Junglyfly/SYSU-EEG-BCI/00 - hardward_doc/stm32f407 ads1299.png

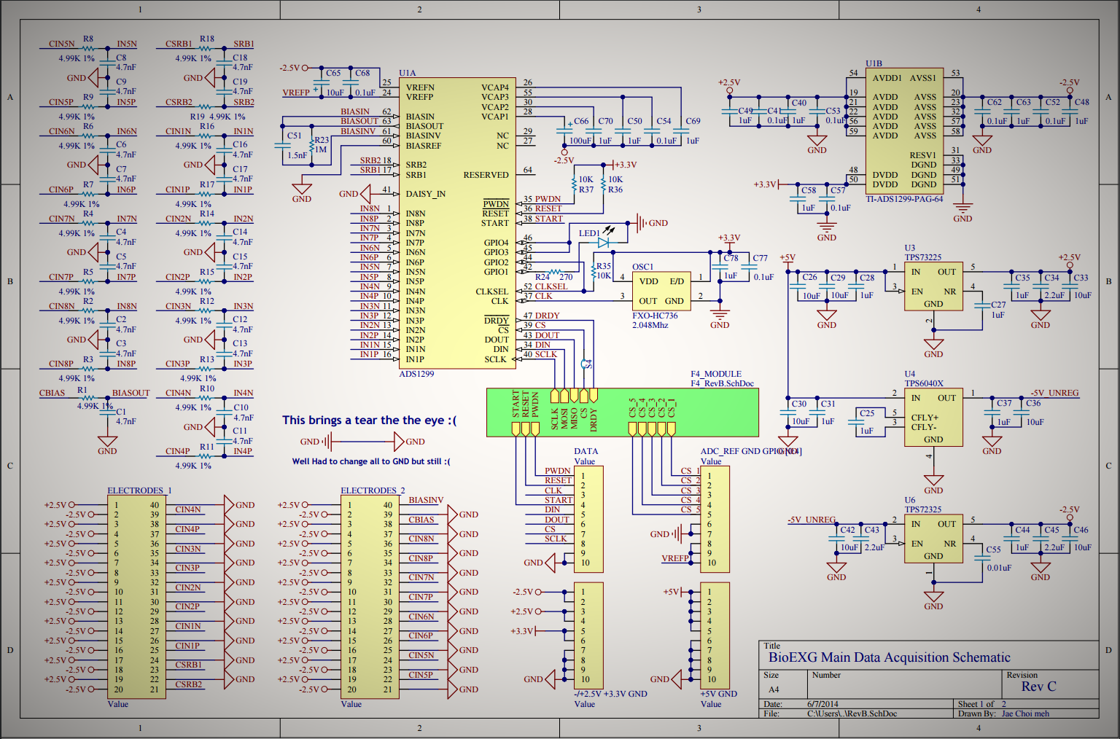
00 - hardward_doc/stm32f407 ads1299.png
