Junglyfly/SYSU-EEG-BCI/00 - hardward_doc/BIAS 连接多设备方法.PNG

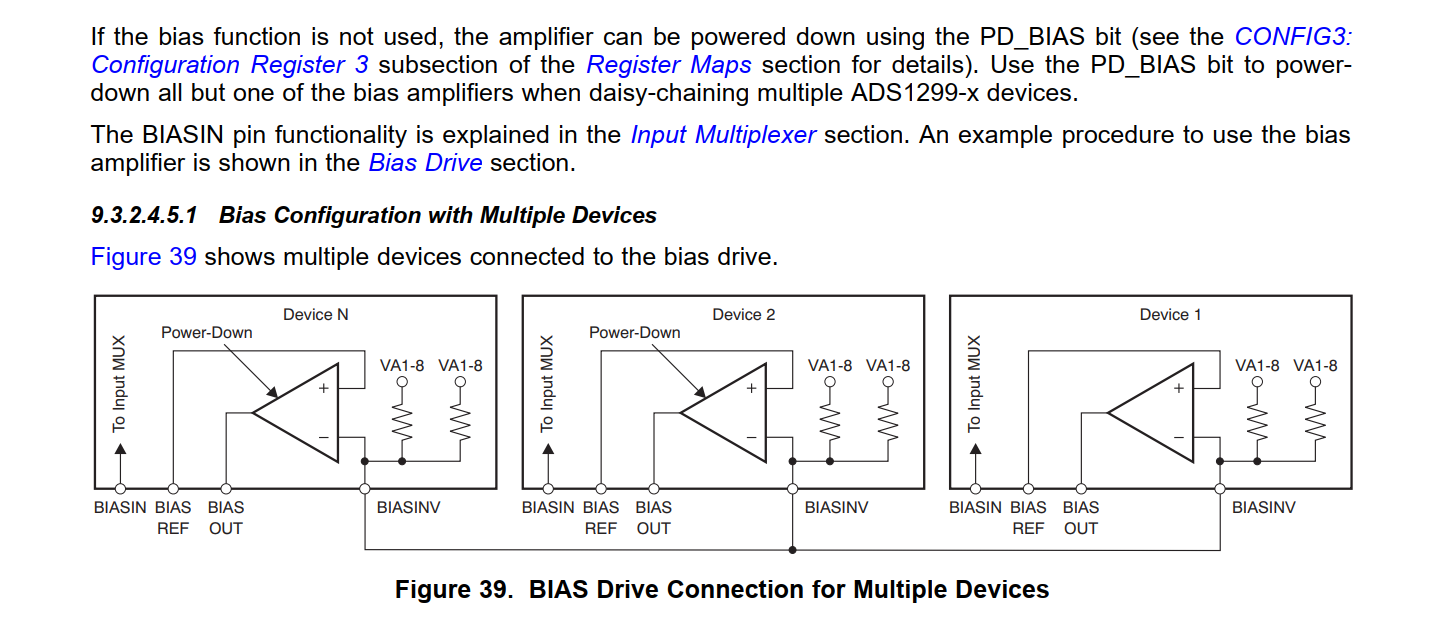
00 - hardward_doc/BIAS 连接多设备方法.PNG
