Junglyfly/SYSU-EEG-BCI/00 - hardward_doc/V3_Hardware_Design_Files-master/OpenBCI Cyton Designs/OBCI_Cyton_Plots/OBCI_Cyton_BOM.xlsx

 | OBCI_V3_C
Item | Board Ref | Qty | Component | Value | Package | Manufacturer | Part Number | Description | Notes
1 | C2,C4 | 2 | C | 100uF | SM 1206 | Yageo | CC1206MKX5R5BB107 | MLCC
2 | C1,C8,C25,C29,C31,C33,C37 | 7 | C | 10uF | SM0603 | Murata | GRM188C80G106KE47D | MLCC
3 | C32,C35,C36,C38,C40 | 5 | C | 2.2uF | EIA_0402 | Murata | GRM155C80J225ME95D | MLCC
4 | C39 | 1 | C | 2.2uF | EIA_0402 | Murata | GRM155R61C225KE44D | MLCC
5 | C6,C7,C14,C17,C18,C19,C21,C22,C27 | 9 | C | 1uF | EIA_0402 | Yageo | CC0402KRX7R5BB105 | MLCC
6 | C5,C10,C12,C13,C15,C24,C28 | 7 | C | 0.1uF | EIA_0402 | Yageo | CC0402KRX7R7BB104 | MLCC
7 | C30 | 1 | C | 0.01uF | EIA_0402 | Yageo | CC0402KRX7R7BB103 | MLCC
8 | C16 | 1 | C | 0.001uF | EIA_0402 | Yageo | CC0402KRX7R7BB102 | MLCC
9 | C20,C23 | 2 | C | 18pF | EIA_0402 | Yageo | CC0402JRNPO9BN180 | MLCC
10 | R1,R2,R3,R4,R6 | 5 | R | 2.2K | SM | BOURNS | CAY16-2201F4LF | 4 R-ARRAY
11 | C3,C9,C11,C26,C34 | 5 | C | 0.001uF | SM | TDK | CKCL44X7R1H102M085AA | 4 CAP ARRAY
12 | U1 | 1 | U |  | LGA | ST | LIS3DHTR | ST ACCELEROMETER
13 | U2 | 1 | U |  | SM | TI | SN74LVC1G32DCKR | OR_GATE
14 | U3 | 1 | U |  | SOT-23-6 | TI | LM2664M6/NOPB | V INVERTER
15 | U4 | 1 | U |  | SOT-23-5 | TI | TLV70025QDDCRQ1 | +2.5V LDO REG
16 | U5 | 1 | U |  | SM | Microchip | MCP1754T-3302E/OT | 3V3 LDO REG
17 | U6 | 1 | U |  | TQFP-64 | TI | ADS1299IPAG | ADS1299 | Consigned by OpenBCI, Inc
18 | U7 | 1 | U |  | SSOP-28 | Microchip | PIC32MX250F128B-I/SS | PIC32 MICROCONTROLLER
19 | VR1 | 1 | VR |  | SM | TI | TPS72325DBVR | -2.5 LDO REG
20 | BLE1 | 1 | BLE |  | SM | RF DIGITAL | RFD22301 | BTLE Module | Consigned by OpenBCI, Inc
21 | D1 | 1 | D | LED | SM 0603 | Lite-On | LTST-C193TBKT-5A | BLUE LED
22 | D8 | 2 | D |  | SM 0603 | Comchip | CDSU400B | DIODE
23 | D9 | 1 | D |  | SM 0603 | Comchip | CDBU0130L | DIODE
24 | D2,D3,D4,D5,D6,D7 | 6 | D |  | SM | TI | TPD4E1B06DCKR | TI QUAD TVS
25 | D10 | 1 | D | 3V | SOD-923 | Comchip | CZRQR52C3-HF | 3V Zener Diode
26 | R8,R10,R11 | 3 | R | 1K | EIA_0402 | Yageo | RT0402FRE071KL | Resistor
27 | R5 | 1 | R | 1M | EIA_0402 | Yageo | RC0402JR-071ML | Resistor
28 | R7,R9 | 2 | R | 470K | EIA_0402 | Yageo | RC0402JR-07470KL | Resistor
29 | X1 | 1 | X | 8MHz | SM | ABRACON | ABMM2-8.000MHZ-E2-T | 8MHz XTAL
30 | B1 | 1 | BATT |  | SM | JST Sales | S2B-PH-SM4-TB(LF)(SN) | CONN HEADER PH SIDE 2POS 2MM SMD
31 | SW2 | 1 | S |  | SM | COPAL | CUS-13TB | SP3T SLIDE SWITCH
32 | SW1,SW3 | 2 | S |  | SM | C&K | PTS810 SJK 250 SMTR LFS | TACT SWITCH
33 | CONN1 | 1 | CONN |  | SM |  |  | microSD card slot | Consigned by OpenBCI, Inc
34 | PL1 | 1 | J |  | DIP | Wurth | 61302221021 | Dual 11 x 2 0.1" pitch MALE header row Right Angle
