Junglyfly/SYSU-EEG-BCI/00 - hardward_doc/V3_Hardware_Design_Files-master/OpenBCI Daisy Designs/OBCI_Daisy_Plots/OBCI_Daisy_BOM.xlsx

 | OBCI_V3_D
Item | Board Reference | Qty | Component | Value | Package | Manufacturer | Part Number | Description | Notes
1 | U1 | 1 | U |  | TQFP-64 | TI | ADS1299IPAG | ADS1299 | Consigned by OpenBCI, Inc
2 | D1,D2,D3,D4,D5,D6 | 6 | D |  | SM | TI | TPD4E1B06DCKR | QUAD TVS
3 | C2 | 1 | C | 100uF | SM 1206 | Yageo | CC1206MKX5R5BB107 | Capacitor, Surface Mount Multi-Layer Ceramic
4 | C1 | 1 | C | 10uF | SM0603 | Murata | GRM188C80G106KE47D | Capacitor, Surface Mount Multi-Layer Ceramic
5 | C3,C6,C8,C14,C19,C22 | 6 | C | 0.1uF | EIA_0402 | Yageo | CC0402KRX7R7BB104 | Capacitor, Surface Mount Multi-Layer Ceramic
6 | C9 | 1 | C | 0.001uF | EIA_0402 | Yageo | CC0402KRX7R7BB102 | Capacitor, Surface Mount Multi-Layer Ceramic
7 | C4,C5,C7,C10,C15,C16,C17,C18,C21 | 9 | C | 1uF | EIA_0402 | Yageo | CC0402KRX7R5BB105 | Capacitor, Surface Mount Multi-Layer Ceramic
8 | C11,C12,C13,C20,C23 | 5 | C | 0.001uF | SM | TDK | CKCL44X7R1H102M085AA | 4 CAPACITOR ARRAY
9 | R1,R2,R3,R4,R6 | 5 | R | 2.2K | SM | BOURNS | CAY16-2201F4LF | 4 R-ARRAY
10 | R5 | 1 | R | 1M | EIA_0402 | Yageo | RC0402JR-071ML | Resistor
11 | PL1 | 1 | J |  | DIP | Wurth | 61302221021 | Dual 11 x 2 0.1" pitch MALE header row Right Angle
