Junglyfly/SYSU-EEG-BCI/00 - hardward_doc/V3_Hardware_Design_Files-master/OpenBCI Dongle Designs/OBCI_Dongle_Plots/OBCI_Dongle_BOM.xlsx

 | OBCI_V3_B
Item | Board Ref | Qty | Component | Value | Package | Manufacturer | Part Number | Description | Notes
1 | U1 | 1 | FT231X |  | QFN-20 | FTDI | FT231XQ-R | FTDI VCP
2 | BLE1 | 1 | Rfduino |  | SM | Rfdigital | RFD22301 | BTLE Module | Consigned by OpenBCI, Inc
3 | D1,D2 | 2 | ESD_VARISTOR |  | SM_0402 | BOURNS | CG0402MLC-05LG | tsv varistor
4 | D3 | 1 | TVS_D |  | SOD882 | ST | ESDALC6V1-1M2 | transient suppressor
5 | D6 | 1 | SMT_LED | BLUE | SM_0603 | Lite-On | LTST-C193TBKT-5A | BLUE LED
6 | D5 | 1 | SMT_LED | GREEN | SM_0603 | Lite-On | LTST-C191KGKT | GREEN LED
7 | D4 | 1 | SMT_LED | RED | SM_0603 | Lite-On | LTST-C191KRKT | RED LED
8 | L1,L2 | 2 | CHOKE |  | SM_0402 | TDK | MPZ1005S300C | FERRITE CHIP
9 | F1 | 1 | SM_FUSE |  | SM_1812 | BOURNS | MF-MSMF050-2 | FUSE
10 | R6,R7 | 2 | R 0402 | 1K | EIA_0402 | Yageo | RT0402FRE071KL | CHIP RESISTOR
11 | R1,R2 | 2 | R 0402 | 22 Ohm | EIA_0402 | Yageo | RC0402FR-0722RL | CHIP RESISTOR
12 | R3,R4,R5 | 3 | R 0402 | 330 Ohm | SM_0402 | Yageo | RC0402JR-07330RL | CHIP RESISTOR
13 | C1,C5, C6 | 3 | C | 0.01uF | EIA_0402 | Yageo | CC0402KRX7R7BB103 | MLCC X7R
14 | C2,C3 | 2 | C | 47pF | SM_0402 | Murata | GRM0335C1E470JA01D | MLCC X7R
15 | C4 | 1 | C 10uF | 10uF | SM0603 | Murata | GRM188C80G106KE47D | MLCC X7R
16 | S1 | 1 | SMT_SPDT_Switch |  | SM | ALPS | SSSS811101 | SPDT SLIDE SWITCH
17 | R8, R9 | 2 | R 0402 | 10K | SM_0402 | Yageo | RC0402JR-0710KL | CHIP RESISTOR
