Junglyfly/SYSU-EEG-BCI/03 - eeg_system_doc/所需物品清单.xlsx

脑机设备所需材料
ESP32 WROOM 32核心板 *4 | https://item.taobao.com/item.htm?id=642955973285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
优质杜邦线（公对公*20，母对母20+母对公*20） | https://item.taobao.com/item.htm?id=546594700264&ns=1&abbucket=8 (https://item.taobao.com/item.htm?spm=a230r.1.14.34.69715a85BuVeLG&id=546594700264&ns=1&abbucket=8)
USB无线TTL串口（一对）*1 | https://detail.tmall.com/item.htm?spm=a230r.1.14.11.6ad938a0iUtkVh&id=584022320538&ns=1&abbucket=8
STM32无线调试器*2（太贵可换成有线） | https://detail.tmall.com/item.htm?spm=a220o.1000855.0.0.5a905c00GZTNg0&id=609295409162 | 有线 | https://detail.tmall.com/item.htm?spm=a230r.1.14.26.603b43c6rnYOY9&id=601784122922&ns=1&abbucket=8
STM32H7核心板*4（屏幕+OV2640套餐） | https://detail.tmall.com/item.htm?id=621235801043&ns=1&abbucket=8&skuId=4393176641020
焊台*1 | https://detail.tmall.com/item.htm?id=609759063116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
焊锡膏*1 | https://detail.tmall.com/item.htm?id=637381583541&ns=1&abbucket=6&skuId=4736662402356
助焊剂*1 | https://detail.tmall.com/item.htm?id=593647676186&ns=1&abbucket=6&skuId=4105624120757
功率计*1 | https://item.taobao.com/item.htm?id=634003542216&ns=1&abbucket=6 (https://item.taobao.com/item.htm?spm=a230r.1.14.16.595444a3KubpV8&id=634003542216&ns=1&abbucket=6)
万用表*1 | https://detail.tmall.com/item.htm?id=575150047847&ns=1&abbucket=6&skuId=4564572616669
数控电源*1 | https://detail.tmall.com/item.htm?id=558714975926&ns=1&abbucket=6&skuId=4506178394576
Micor usb*2 | https://detail.tmall.com/item.htm?id=615760110517&ns=1&abbucket=6&skuId=4542405808575
10000mAh充电宝*1（测试功率用） | https://detail.tmall.com/item.htm?id=577153769994&ns=1&abbucket=6&skuId=4686327168997
