Junglyfly/SYSU-EEG-BCI/00 - hardward_doc/ESP32 核心板资料/ESP32-WROVER-E_V1.2_Reference Design/01_Schematic/SCH_ESP32-WROVER-E_V1.2_20200727.pdf

# Hardware Block:

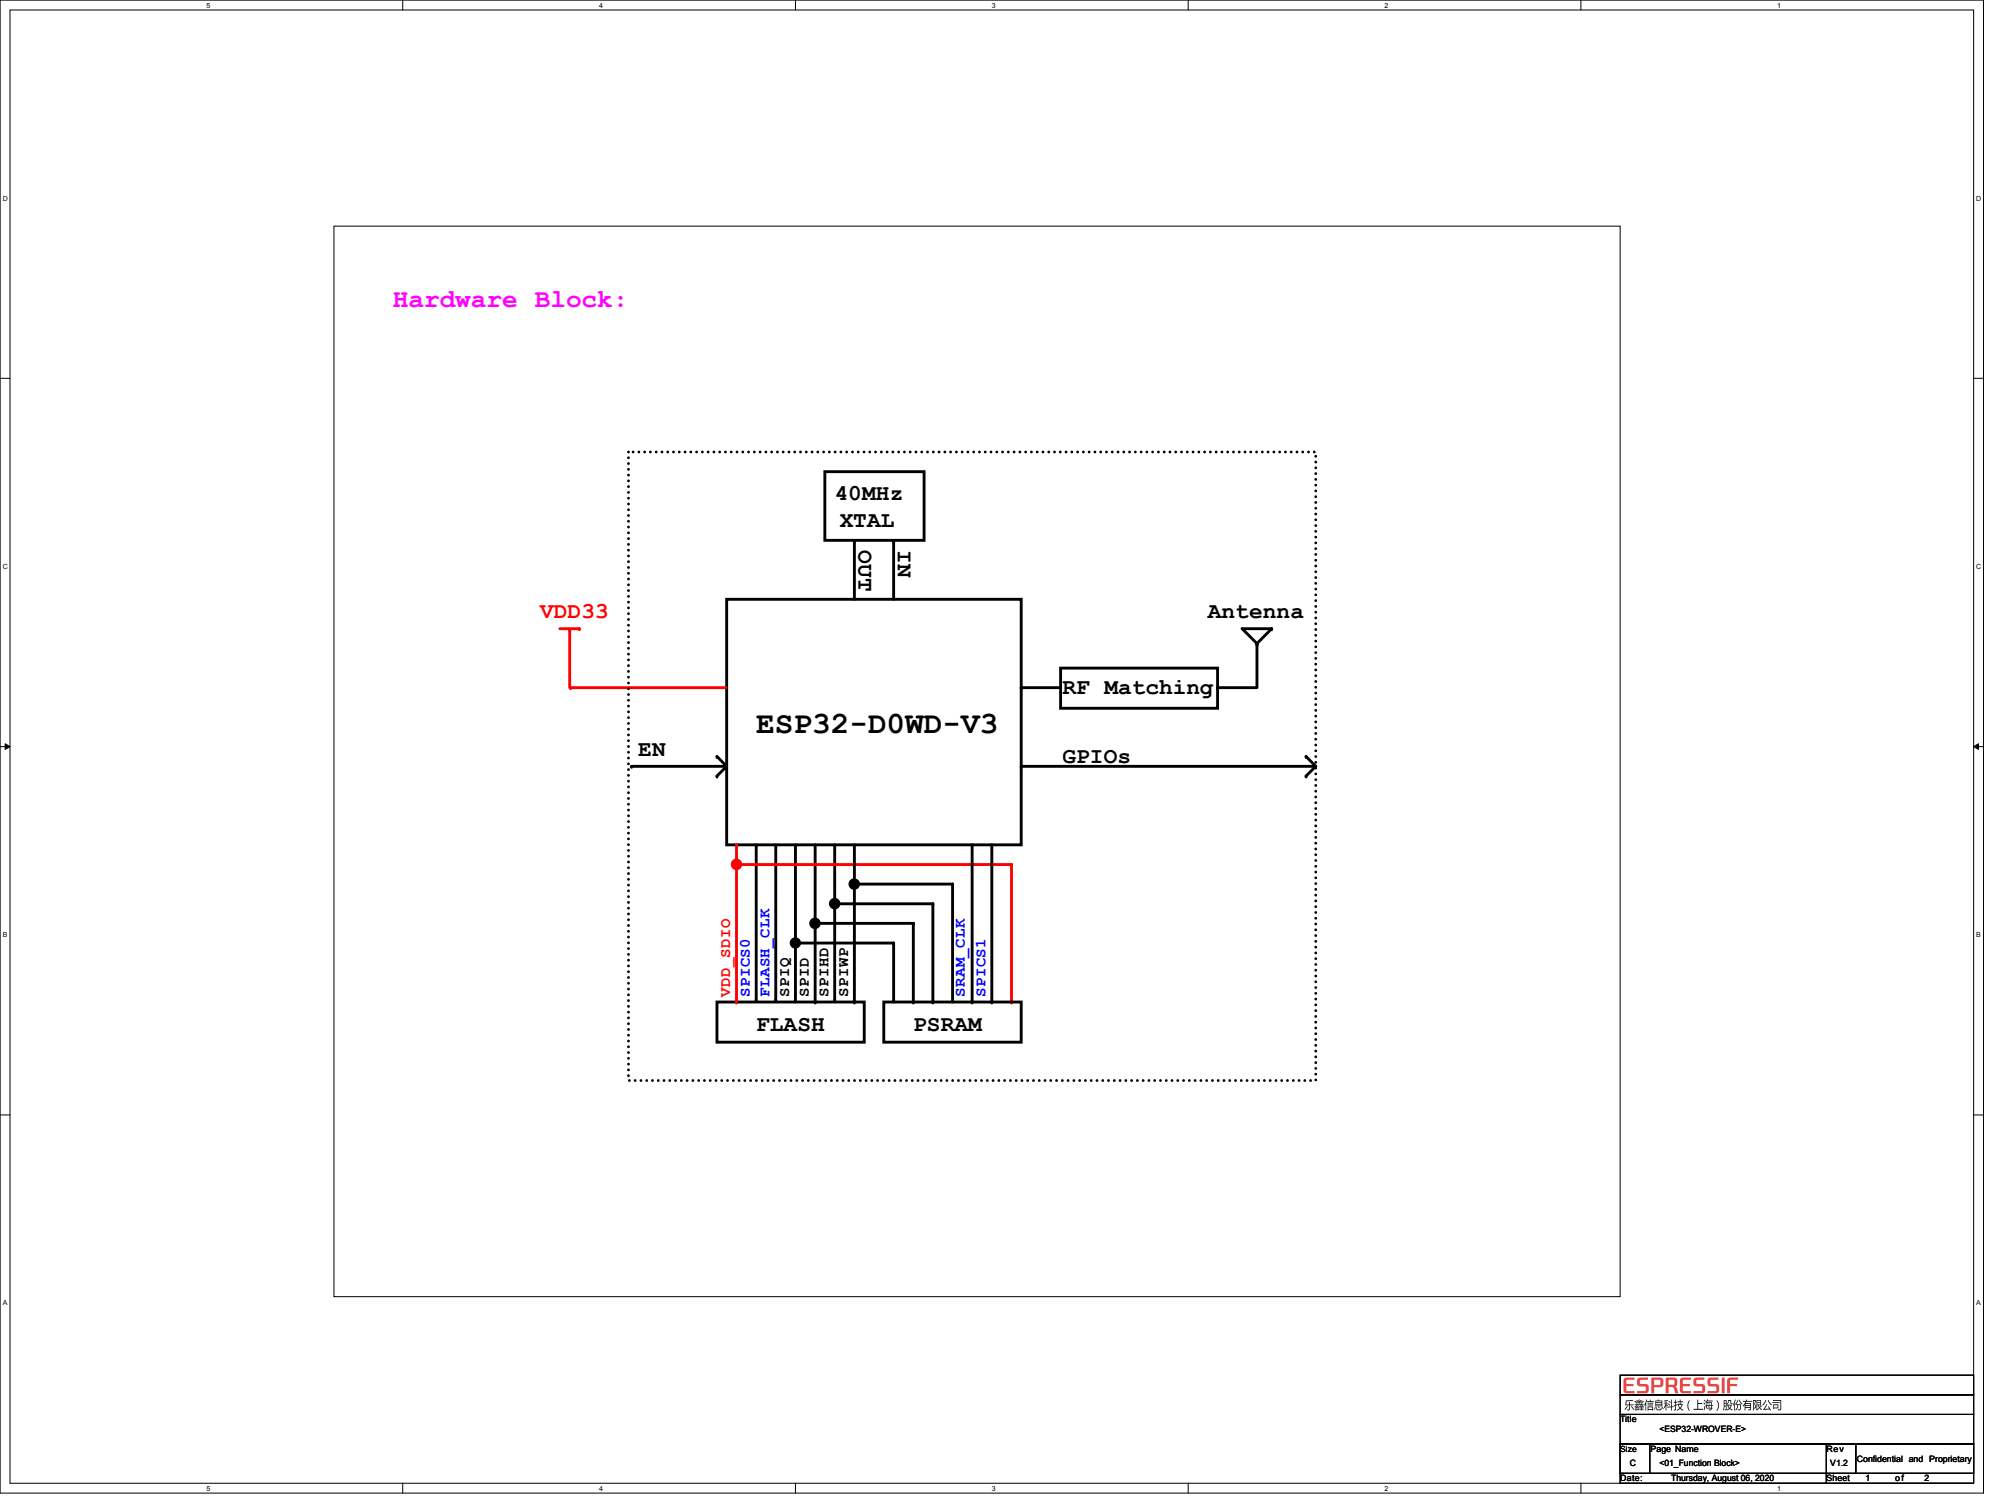
[picture p38: page 1]
RF Matching; Antenna; ESP32-D0WD-V3; FLASH; VDD33; OUT; 40MHz XTAL; VDD_SDIO; SPICS0; FLASH_CLK; SPIQ; SPID; SPIHD; GPIOs; SPIWP; PSRAM; SRAM_CLK; SPICS1; Title; Size; Page Name; Rev; Date:; Sheet; Confidential and Proprietary <01_Function Block>; <ESP32-WROVER-E>; Thursday, August 06, 2020

5

4

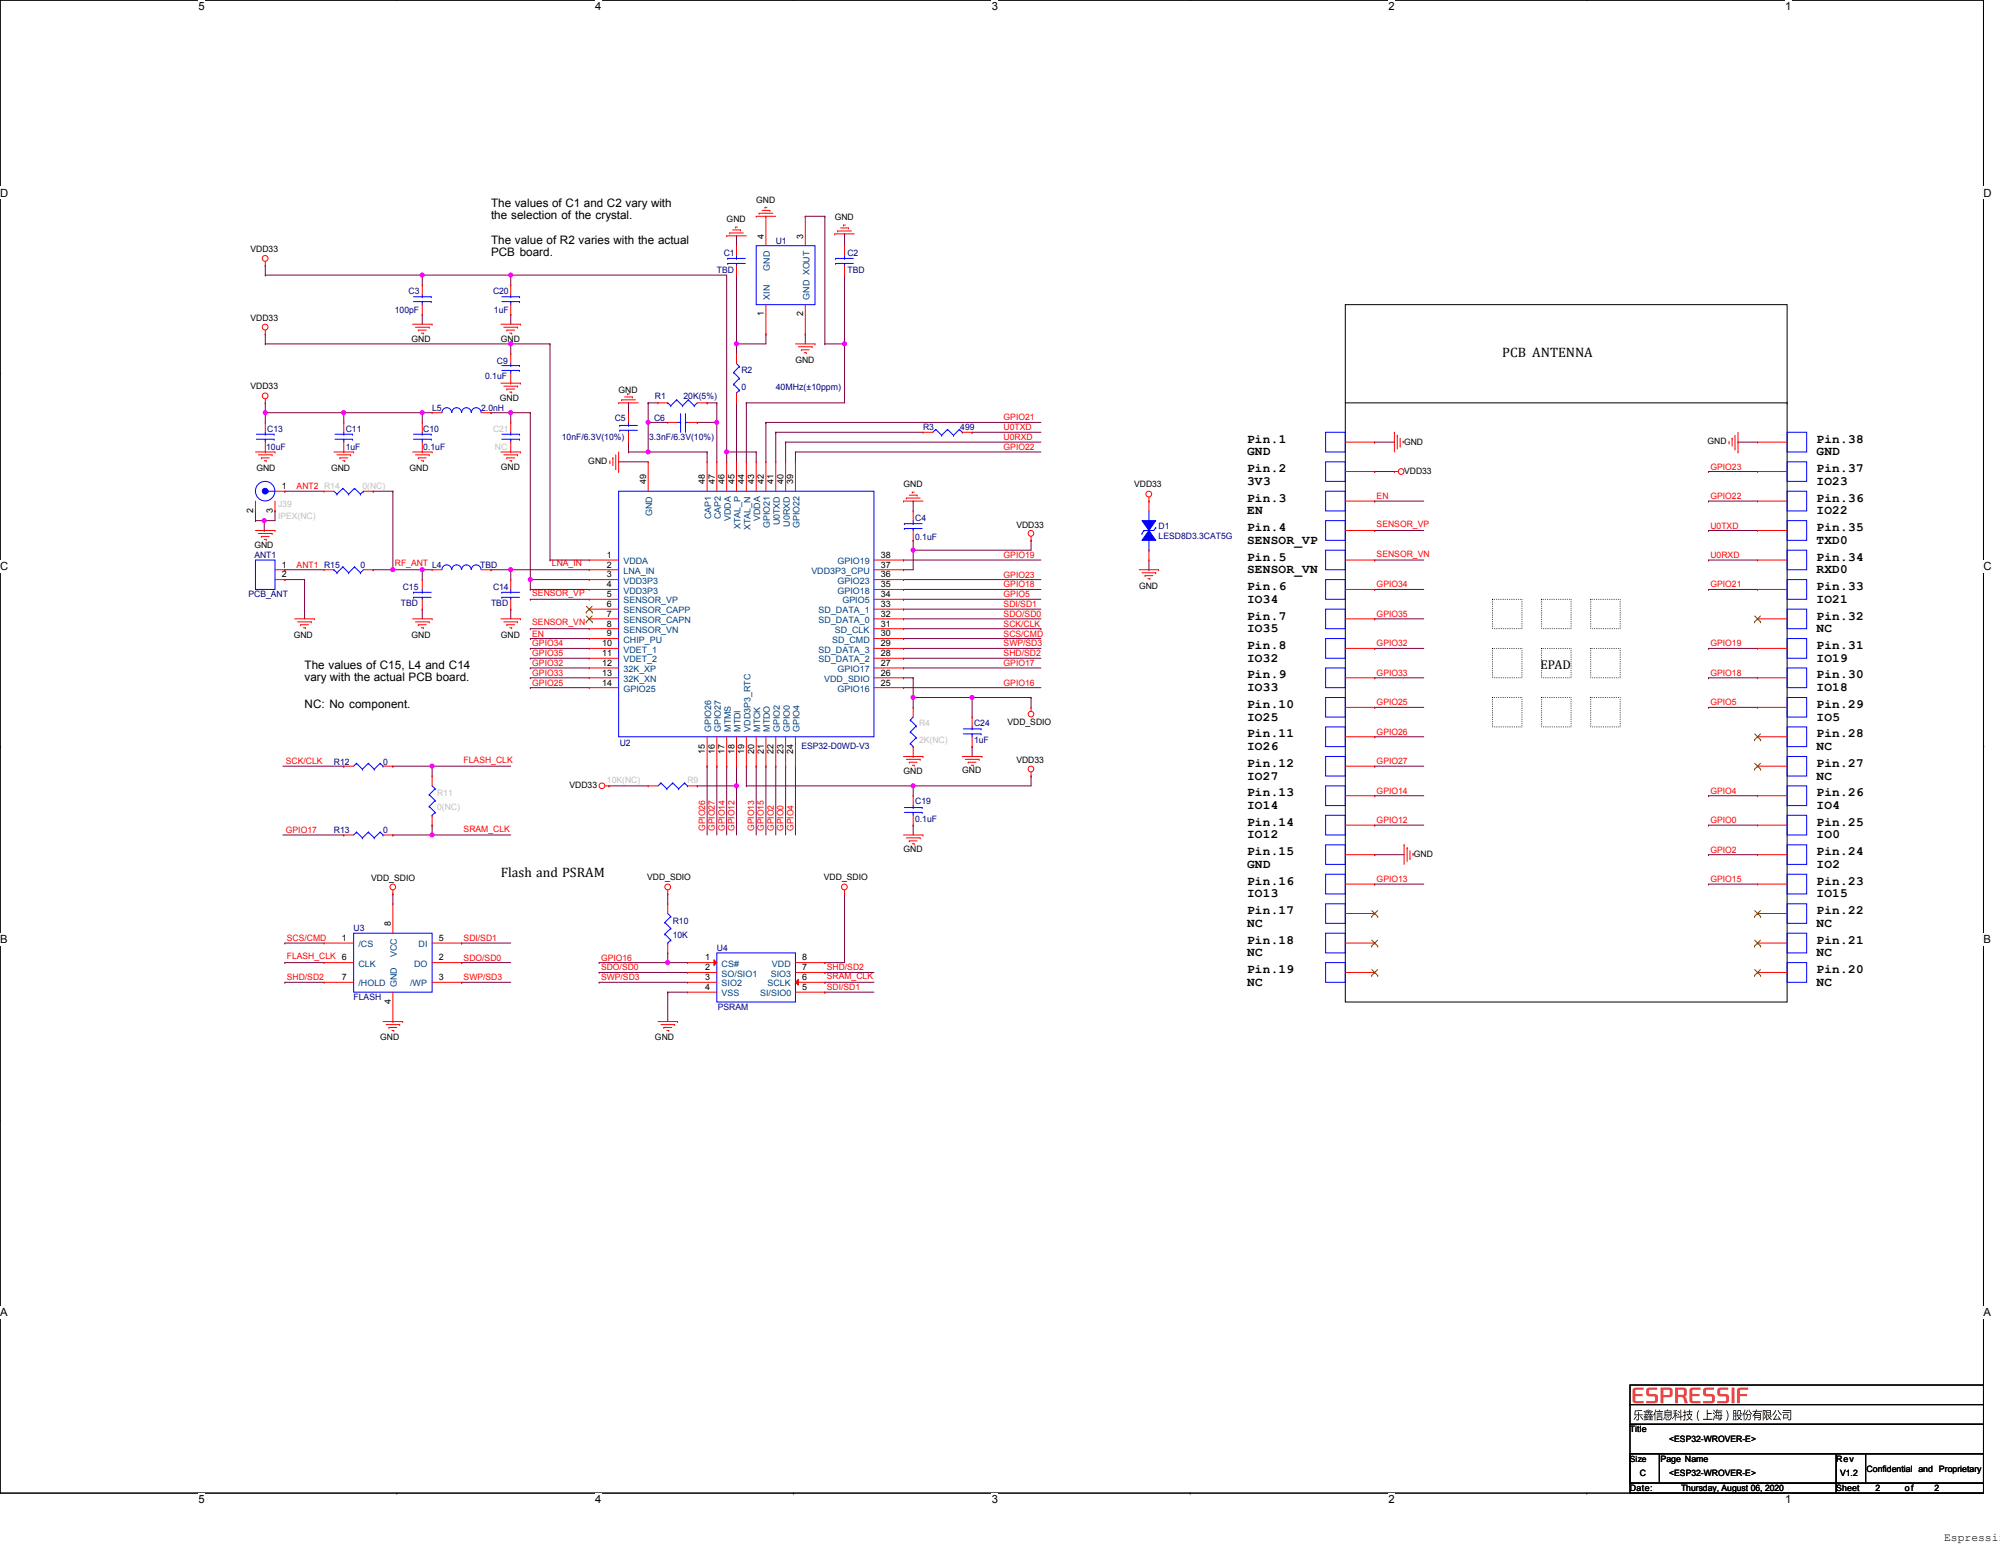
[picture p39: page 2]

The values of C1 and C2 vary with
the selection of the crystal.

The value of R2 varies with the actual
PCB board.

The values of C15, L4 and C14
vary with the actual PCB board.
