Junglyfly/SYSU-EEG-BCI/00 - hardward_doc/OpenBCI原理图参考/Schematic Design OpenBCI 8bit.pdf

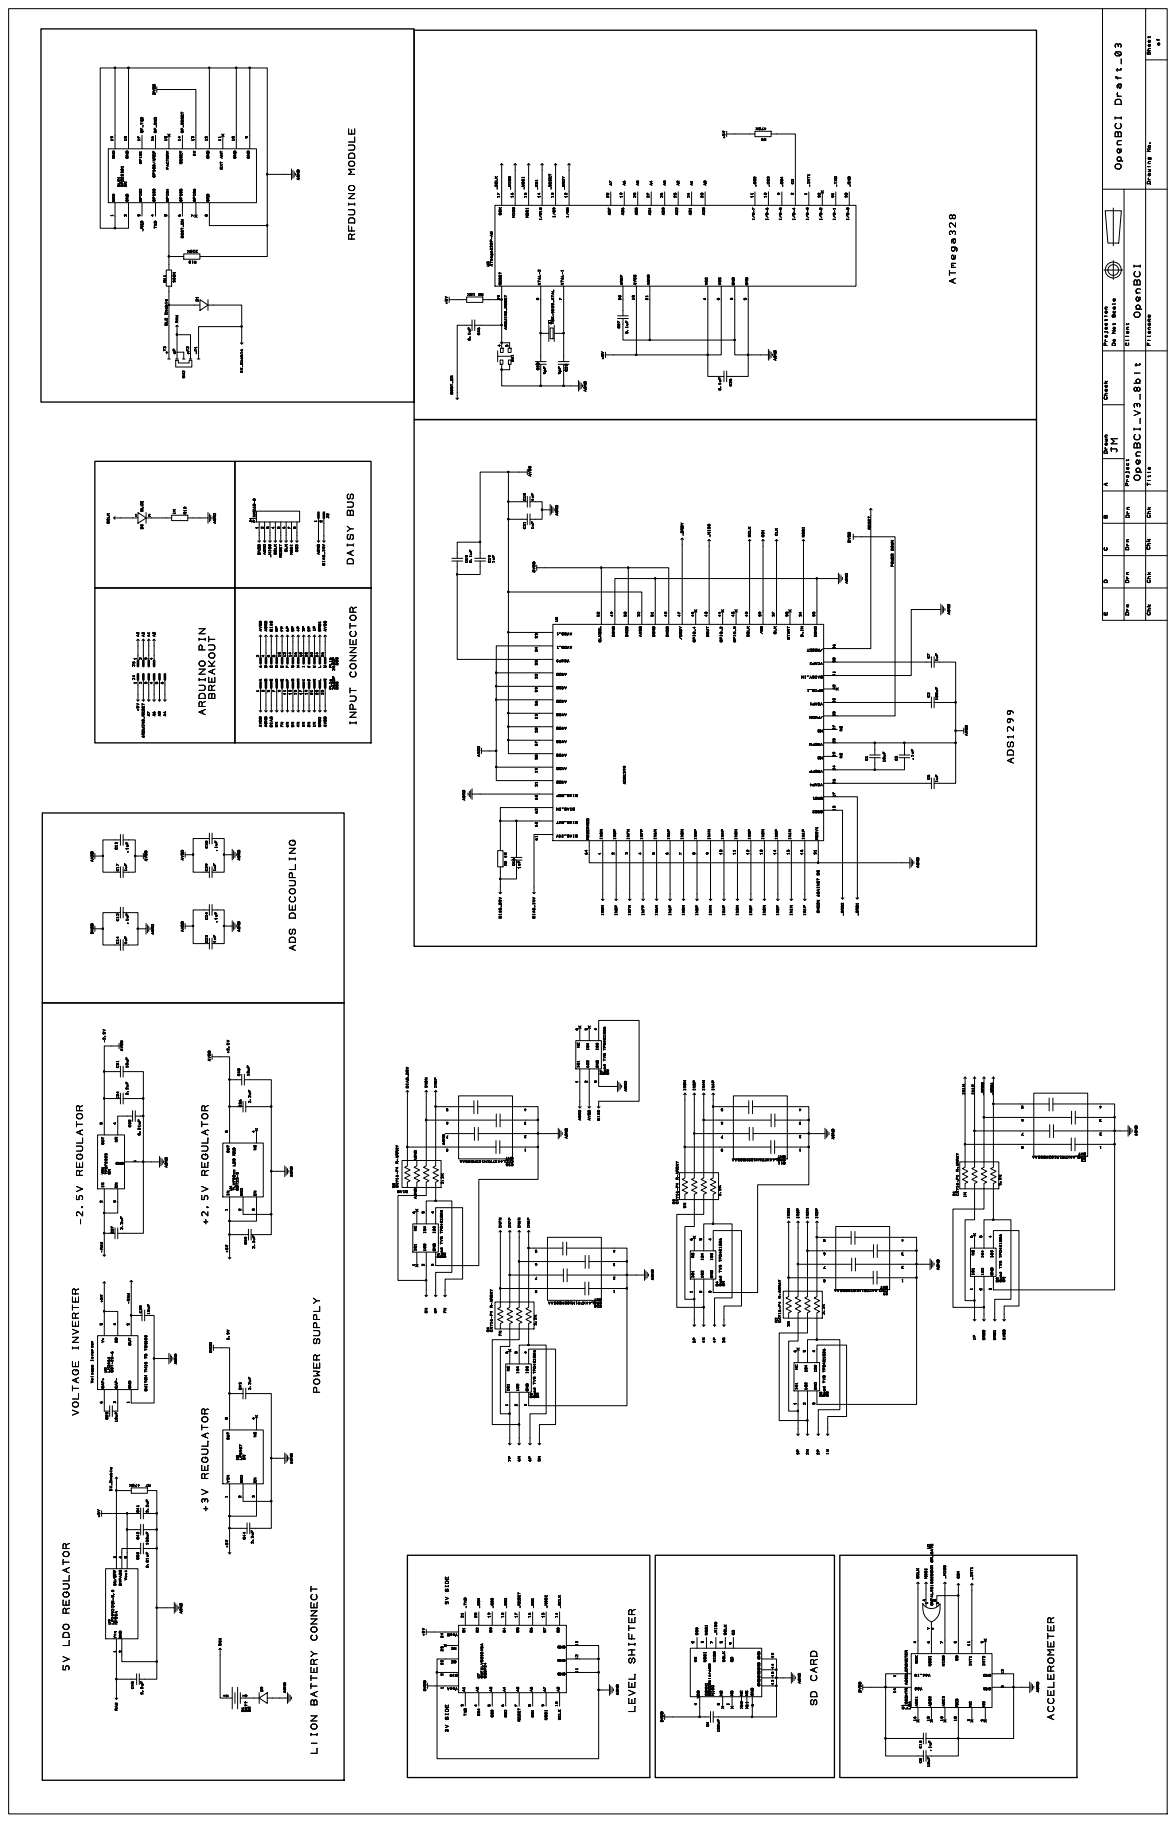
[picture p40: page 1]
