Junglyfly/SYSU-EEG-BCI/00 - hardward_doc/OpenBCI原理图参考/Schematic Design OpenBCI Dongle.pdf

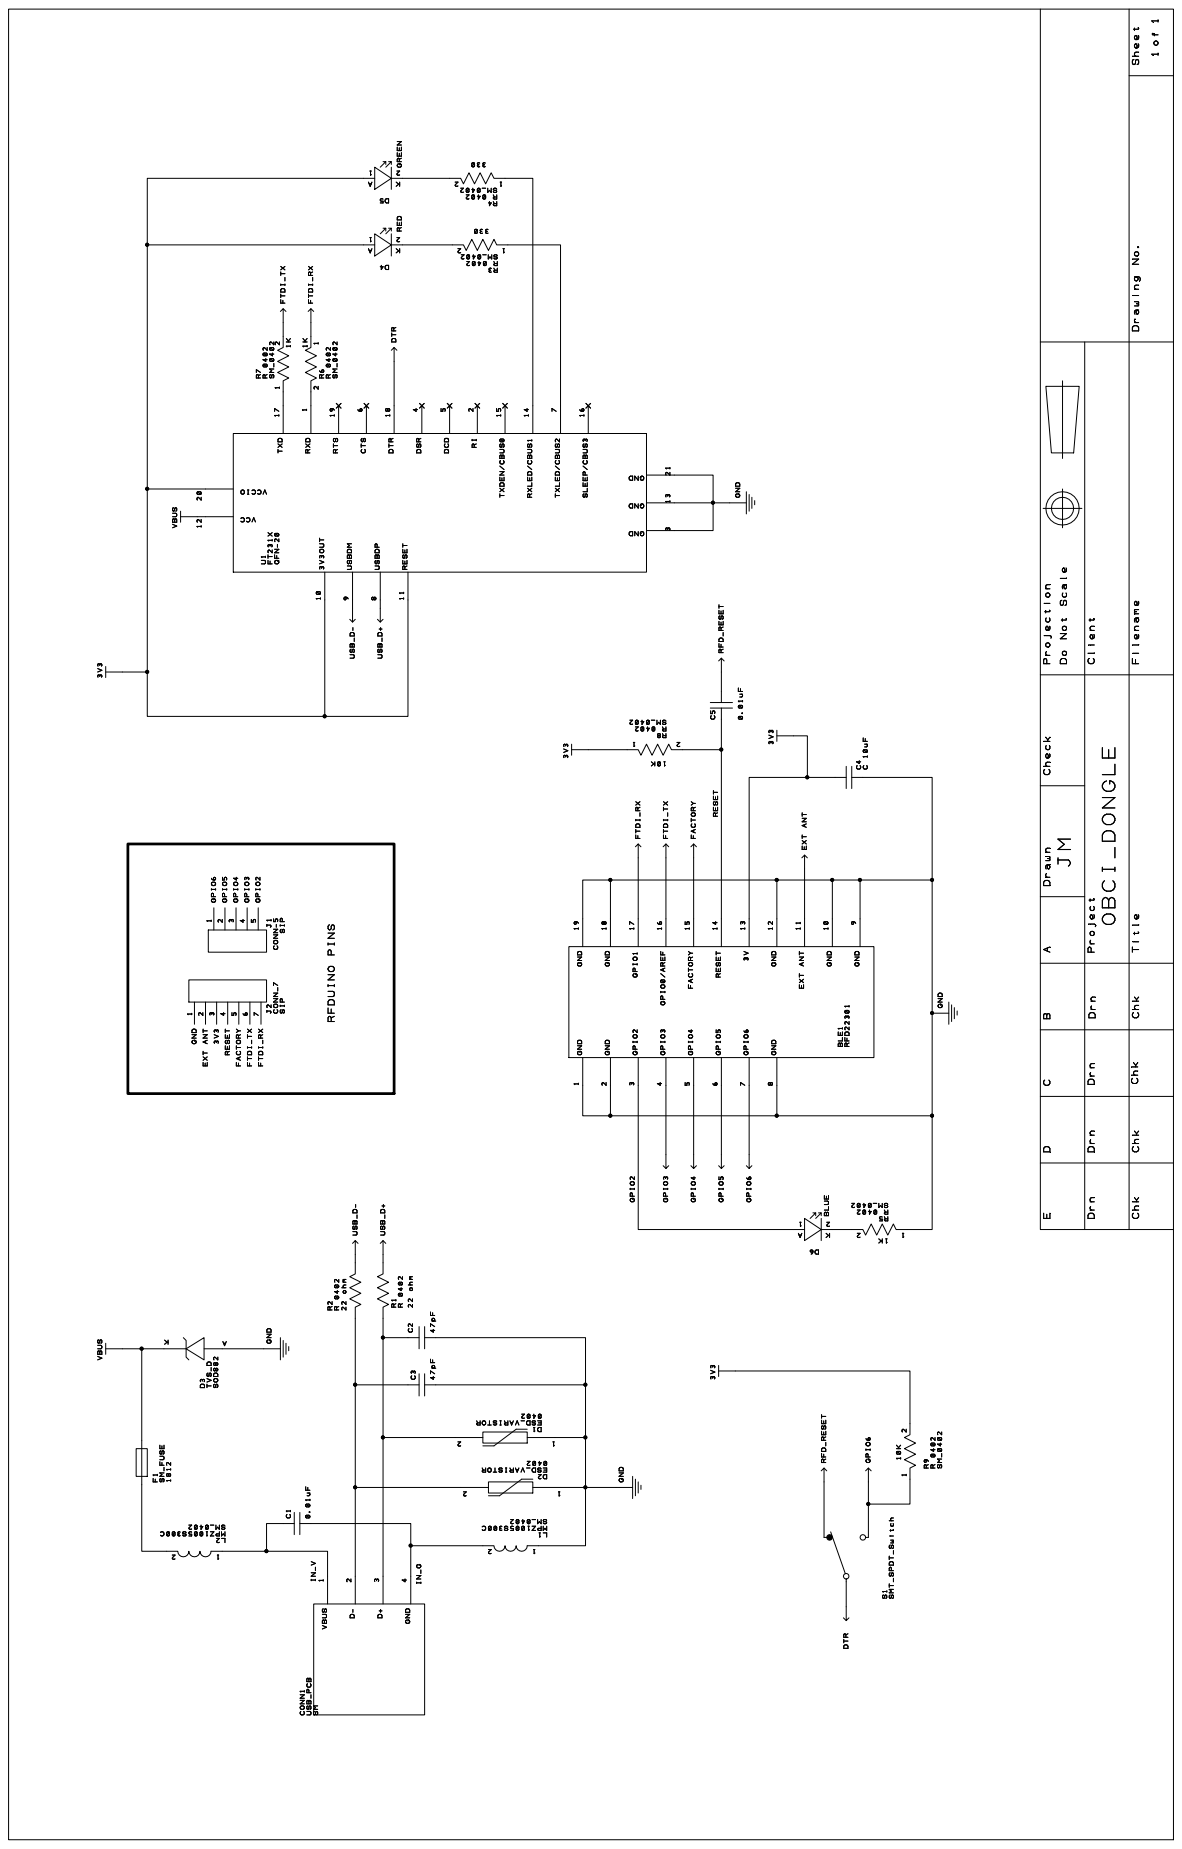
[picture p41: page 1]
