Junglyfly/SYSU-EEG-BCI/00 - hardward_doc/OpenBCI原理图参考/ads1299单独板原理图.pdf

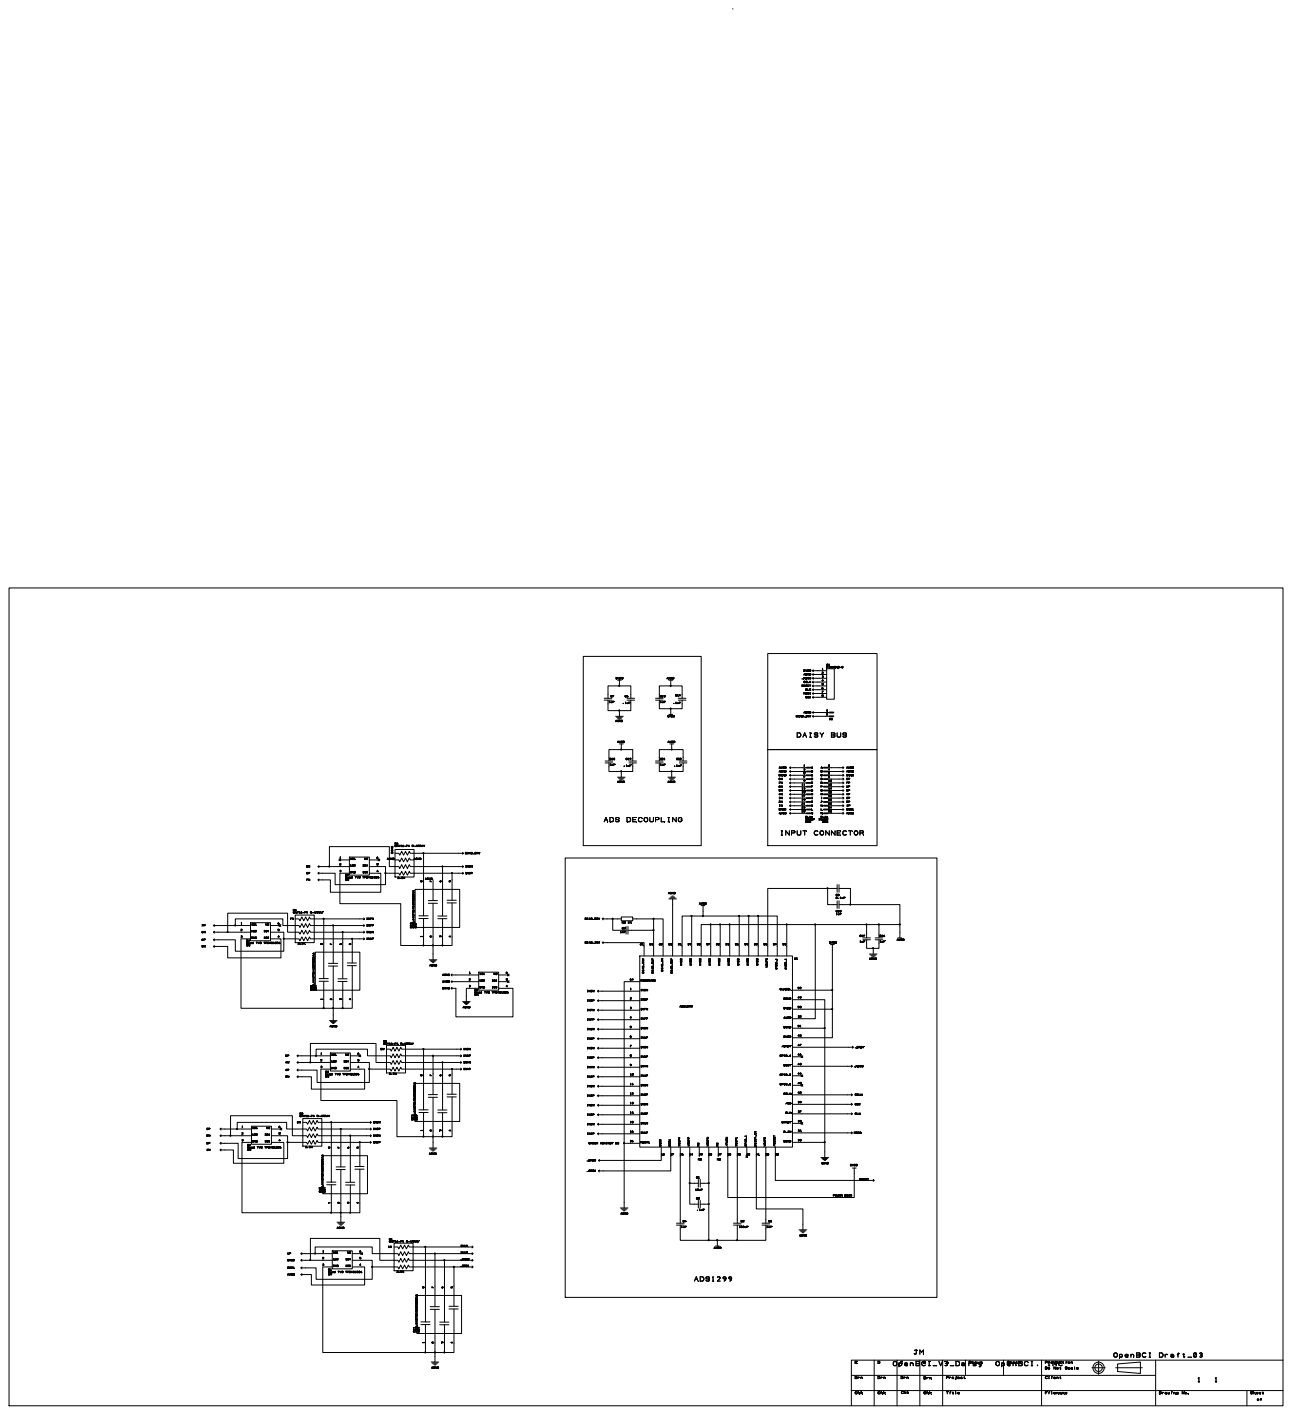
[picture p42: page 1]
