Junglyfly/SYSU-EEG-BCI/00 - hardward_doc/OpenBCI原理图参考/OpenBCI原理图.pdf

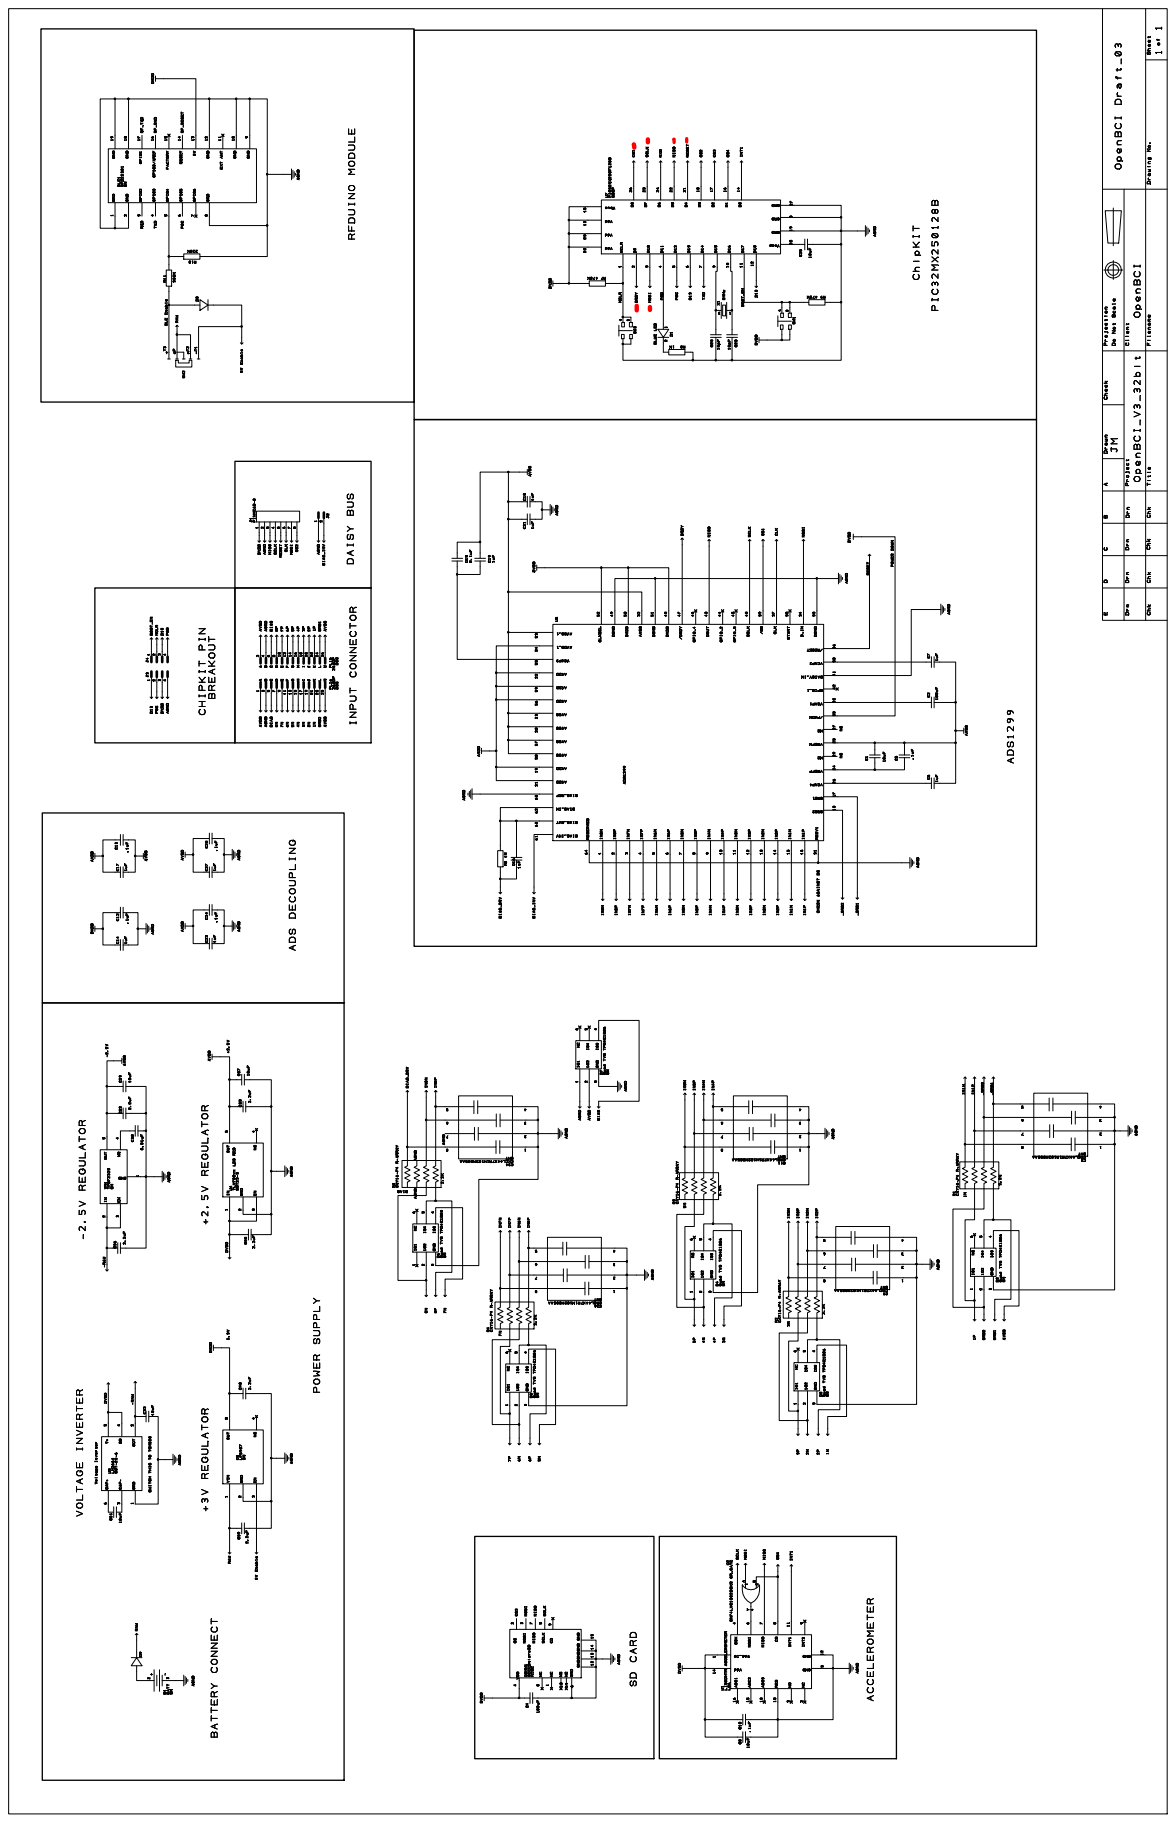
[picture p43: page 1]
