Junglyfly/SYSU-EEG-BCI/(list of files, drawings)

Other design files:
00 - hardward_doc/ESP32 核心板资料/ESP32-WROVER-E_V1.2_Reference Design/01_Schematic/SCH_ESP32-WROVER-E_V1.2_20200727.DSN
00 - hardward_doc/ESP32 核心板资料/ESP32-WROVER-E_V1.2_Reference Design/02_PCB Layout/PCB_ESP32-WROVER-E_V1.2_20200102.pcb
00 - hardward_doc/SCH_脑机检测_2021-08-07.json
00 - hardward_doc/V3_Hardware_Design_Files-master/OpenBCI 8bit Designs/OpenBCI 8bit.pcb
00 - hardward_doc/V3_Hardware_Design_Files-master/OpenBCI Cyton Designs/OpenBCI 32bit.pcb
00 - hardward_doc/V3_Hardware_Design_Files-master/OpenBCI Daisy Designs/OpenBCI Daisy.pcb
00 - hardward_doc/V3_Hardware_Design_Files-master/OpenBCI Dongle Designs/OpenBCI Dongle.pcb
