Junglyfly/SYSU-EEG-BCI/02 - source_code/EEF_STM32_code/EEGads1299/ADS1298/inc/stdef.h

/*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
                              *
*       Change Description:       {describe change}                                                                                               *
*                                                                                                                                                 *
**************************************************************************************************************************************************/
/**************************************************************************************************************************************************
*               Union Structures and Definitions                                                                                                  *
**************************************************************************************************************************************************/
// BITWISE Definitions
//#define DISABLE                 0
//#define ENABLE                  1

#define DEFAULT_DISABLE         0
#define DEFAULT_ENABLE          1

#define DISABLED                0
#define ENABLED                 1

#define DEFAULT_DISABLED        0
#define DEFAULT_ENABLED         1

#define LOW                     0
#define HIGH                    1

#define DEFAULT_LOW             0
#define DEFAULT_HIGH            1

#define INACTIVE                0
#define ACTIVE                  1

#define CLEAR                   0
#define SET                     1

#define OFF                     0
#define ON                      1

#define NULL                    0
