Junglyfly/SYSU-EEG-BCI/02 - source_code/EEF_STM32_code/EEGads1299/Core/Inc/main.h

#define Board_Led_Pin GPIO_PIN_3
#define Board_Led_GPIO_Port GPIOE
#define Board_KEY_Pin GPIO_PIN_13
#define Board_KEY_GPIO_Port GPIOC
#define Ads_1_START_Pin GPIO_PIN_0
#define Ads_1_START_GPIO_Port GPIOC
#define Ads_1_SPI2_MOSI_Pin GPIO_PIN_1
#define Ads_1_SPI2_MOSI_GPIO_Port GPIOC
#define Ads_1_SPI2_MISO_Pin GPIO_PIN_2
#define Ads_1_SPI2_MISO_GPIO_Port GPIOC
#define Ads_1_SPI_CS_Pin GPIO_PIN_3
#define Ads_1_SPI_CS_GPIO_Port GPIOC
#define Ads_1_DRDY_Pin GPIO_PIN_0
#define Ads_1_DRDY_GPIO_Port GPIOA
#define Ads_1_DRDY_EXTI_IRQn EXTI0_IRQn
#define Ads_1_RESET_Pin GPIO_PIN_1
#define Ads_1_RESET_GPIO_Port GPIOA
#define Ads_1_PWDN_Pin GPIO_PIN_2
#define Ads_1_PWDN_GPIO_Port GPIOA
#define Ads_2_SPI6_CS_Pin GPIO_PIN_4
#define Ads_2_SPI6_CS_GPIO_Port GPIOA
#define Ads_2_SPI6_SCK_Pin GPIO_PIN_5
#define Ads_2_SPI6_SCK_GPIO_Port GPIOA
#define Ads_2_SPI6_MISO_Pin GPIO_PIN_6
#define Ads_2_SPI6_MISO_GPIO_Port GPIOA
#define Ads_2_SPI6_MOSI_Pin GPIO_PIN_7
#define Ads_2_SPI6_MOSI_GPIO_Port GPIOA
#define Ads_1_SPI2_SCK_Pin GPIO_PIN_10
#define Ads_1_SPI2_SCK_GPIO_Port GPIOB
