Junglyfly/SYSU-EEG-BCI/(commit log)

2021-08-28 first backup
    [BOM(V0.5)_ESP32-WROVER-E_V1.2_20200727.xlsx, OBCI_Cyton_ Component Positions.csv, OBCI_Cyton_BOM.xlsx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]
2021-09-01 删除了一些不必要文档
    [acquire.obj, convD2M.obj, convM2D.obj, convM2S.obj, convS2M.obj, estyx.obj, mmb0.obj, mmb0bfifo.obj]
