Junglyfly/SYSU-EEG-BCI/(notices)

Notices in the files:
02 - source_code/EEF_STM32_code/EEGads1299/ADS1298/inc/stdef.h:
Copyright © 2009-2010 Texas Instruments Incorporated - http://www.ti.com
02 - source_code/EEF_STM32_code/EEGads1299/ADS1298/scr/dma.c:
Copyright(C) ¹ãÖÝÊÐÐÇÒíµç×Ó¿Æ¼¼ÓÐÏÞ¹«Ë¾ 2009-2019
All rights reserved
02 - source_code/EEF_STM32_code/EEGads1299/Core/Inc/main.h:
© Copyright (c) 2021 STMicroelectronics.
This software component is licensed by ST under BSD 3-Clause license,
the "License"; You may not use this file except in compliance with the
License. You may obtain a copy of the License at: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
(C) COPYRIGHT STMicroelectronics *****END OF FILE
